jcondor98/avrtmon/resources/schematics/pcb-layout.jpg

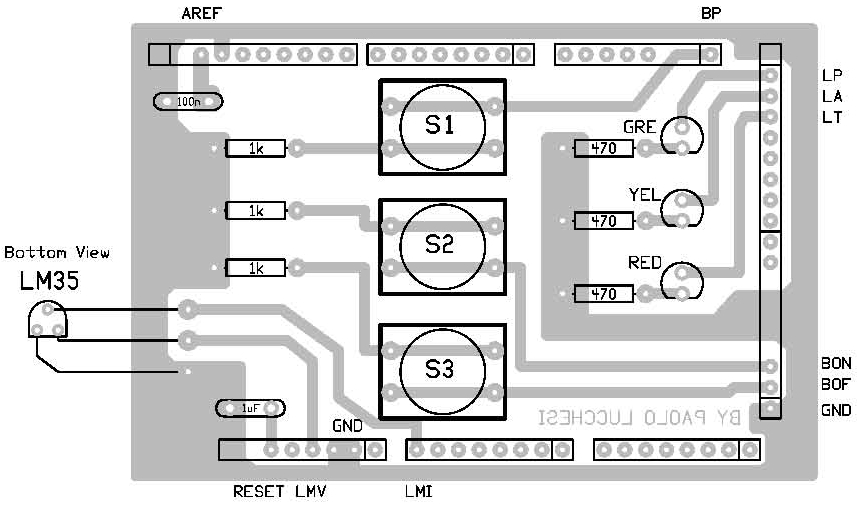
resources/schematics/pcb-layout.jpg
