jcondor98/avrtmon/resources/schematics/pcb-master.jpg

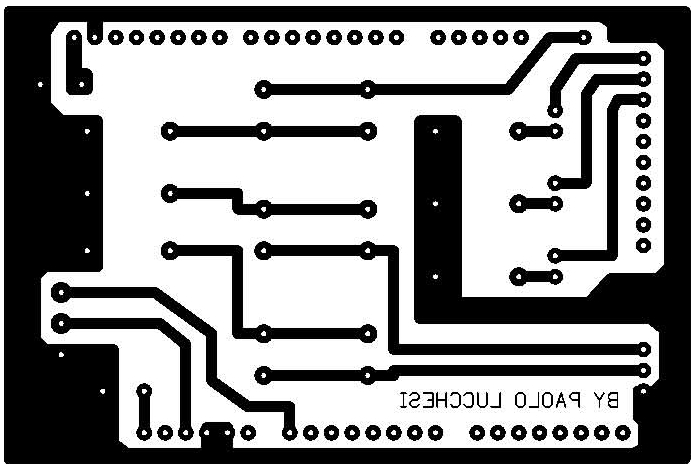
resources/schematics/pcb-master.jpg
