jcondor98/avrtmon/resources/schematics/schematics.jpg

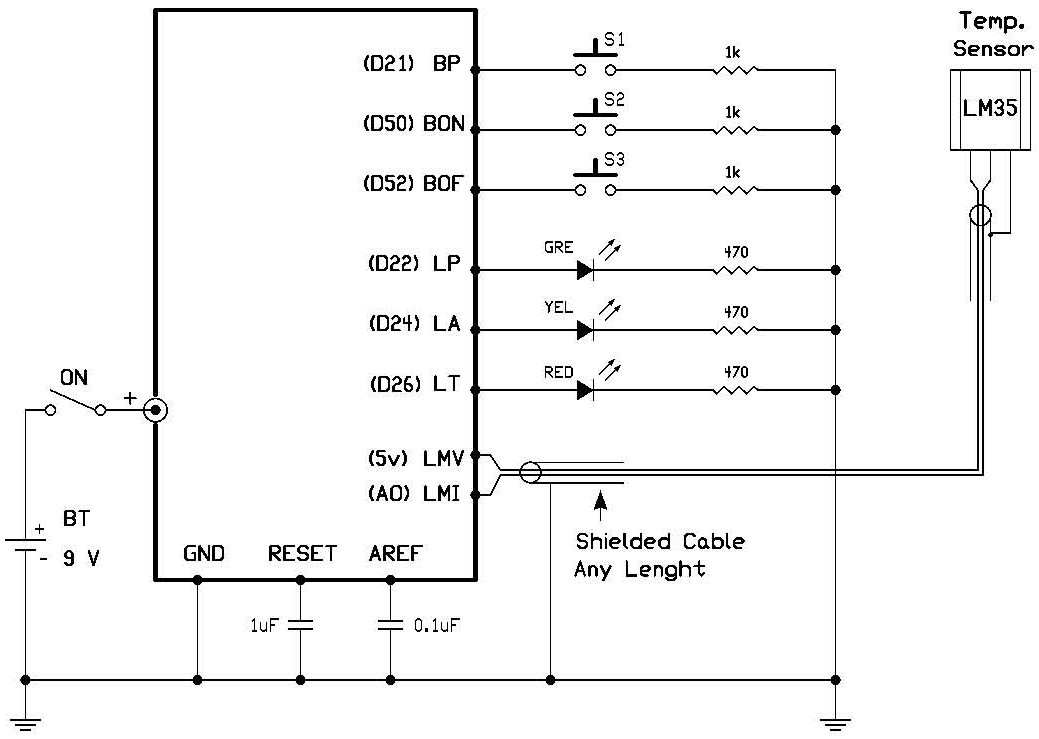
resources/schematics/schematics.jpg
