jcondor98/avrtmon/resources/config/test.csv

field1 | uint8_t | 1
field2 | uint16_t | 2
field3 | uint32_t | 3
