jcondor98/avrtmon/(list of files, drawings)

Other design files:
resources/schematics/pcb-layout.pcb
