jcondor98/avrtmon/sources/host/shell_commands.c

// AVR Temperature Monitor -- Paolo Lucchesi
// Program shell - Commands
#include <stdio.h>
#include <stdlib.h>
#include <stdint.h>
#include <string.h>
#include <assert.h>

#include "shell.h"
#include "list.h"
#include "serial.h"
#include "temperature.h"
#include "communication.h"
#include "debug.h"


// Declare a shell_storage_t variable casted from an opaque pointer
#define _storage_cast(st,opaque) shell_storage_t *st=(shell_storage_t*)(opaque)

// Handier function to send and receive packets
#define SERIAL_CTX (st->serial_ctx) // Must be the context in EVERY function below
#define psend(type,data,data_size)\
  communication_craft_and_send(SERIAL_CTX,type,data,data_size)
#define precv(p) communication_recv(SERIAL_CTX,p)
#define pcmd(cmd,arg,arg_size) communication_cmd(SERIAL_CTX,cmd,arg,arg_size)

// Type definition for the internal shell storage
typedef struct _shell_storage_s {
  serial_context_t *serial_ctx;
  list_t *dbs;
  unsigned db_incr_counter; // Incremental counter for DB IDs
} shell_storage_t;

// Wrapper to destroy DBs when destroying 'dbs'
static void _temperature_db_item_destroyer(void *db) {
  temperature_db_delete(db);
}


// Allocate and initialize a shell storage
// Returns an opaque pointer to the allocated storage, or NULL on failure
void *shell_storage_new(void) {
  shell_storage_t *st = malloc(sizeof(shell_storage_t));
  if (!st) return NULL;

  st->dbs = list_new();
  if (!st->dbs) {
    free(st);
    return NULL;
  }

  SERIAL_CTX = NULL;  // i.e. not connected
  st->db_incr_counter = 0;
  return (void*) st;
}

// Cleanup this shell environment (i.e. free memory, close descriptors...)
// Also frees the shell storage data structure itself
void shell_cleanup(shell_t *s) {
  if (!s) return;
  _storage_cast(st, s->storage);

  // Close the connection with the tmon, if any
  if (SERIAL_CTX && serial_close(SERIAL_CTX) != 0)
    err_log("Could not close the tmon file descriptor");

  // Free the storage
  list_delete(st->dbs, _temperature_db_item_destroyer);
  free(st);
}



// CMD: connect
// Usage: connect <device_path>
// Connect to an avrtmon, given its device file (usually under /dev)
// If it is already connected, reconnect
int connect(int argc, char *argv[], void *storage) {
  _storage_cast(st, storage);
  if (argc < 2) return 1;

  if (SERIAL_CTX)
    fputs("Open serial context found; reconnecting\n", stderr);
  else { // Open a descriptor for the tmon
    SERIAL_CTX = serial_open(argv[1]);
    sh_error_on(!SERIAL_CTX, 2, "Unable to connect to the tmon");
  }

  // Estabilish the connection
  sh_error_on(communication_connect(SERIAL_CTX) != 0, 3,
      "Could not send a handshake packet");

  return 0;
}


// CMD: disconnect
// Usage: disconnect
// Close an existing connection - Has no effect on the tmon
int disconnect(int argc, char *argv[], void *storage) {
  _storage_cast(st, storage);
  if (argc != 1) return 1;
  sh_error_on(!SERIAL_CTX, 2, "tmon is not connected");

  int ret = serial_close(SERIAL_CTX);
  SERIAL_CTX = NULL; // i.e. set to disconnected
  sh_error_on(ret != 0, 3, "Could not close the tmon file descriptor");

  return 0;
}


// CMD: download
// Usage: download
// Download all the temperatures from the tmon, creating a new database
// The communication happens as follows:
// 1] [HOST] <CMD> Request to download
// 2] [AVR]  If next (or first) DB is not empty:
//             <CTR> send DB info
// 3] [AVR]  While there are temperatures in the current DB:
//             <DAT> Send temperatures in data bursts (i.e. in bulk)
// 4] [AVR]  If there is another DB, goto [2]
// 5] [AVR]  <CTR> Piggyback CTR packet with no carried data means end of comm.
int download(int argc, char *argv[], void *storage) {
  _storage_cast(st, storage);
  if (argc > 1) return 1;
  sh_error_on(!SERIAL_CTX, 2, "tmon is not connected");

  // Store DBs in a list
  list_t *db_list = list_new();
  sh_error_on(!db_list, 2, "Could not create new linked list");

  // DB which is currently in reception, with variables to store metadata
  uint8_t db_id;
  uint16_t db_reg_resolution, db_reg_interval;
  temperature_id_t db_size;
  temperature_db_t *db_current = NULL;

  // Buffer and variables for received packets
  packet_t pack_rx[1];
  unsigned char type, data_size;


  // Send a download command to the tmon
  if (pcmd(CMD_TEMPERATURES_DOWNLOAD, NULL, 0) != 0) {
    list_delete(db_list, _temperature_db_item_destroyer);
    sh_error(3, "Could not send CMD packet");
  }

  // Main downloader loop
  while (1) {
    // Receive new packet
    if (precv(pack_rx) != 0) {
      err_log("Unable to receive packet");
      break;
    }
    type = packet_get_type(pack_rx);
    data_size = packet_data_size(pack_rx);

    // New database incoming
    if (type == PACKET_TYPE_CTR) {
      if (data_size == 0) { // No more data to receive
        if (list_size(db_list) == 0) // No temperatures were received
          list_delete(db_list, NULL);
        else {
          list_concat(st->dbs, db_list);
          st->db_incr_counter = db_id + 1; // i.e. += Last ID received
        }
        return 0;
      }

      else if (data_size == sizeof(temperature_db_info_t)) { // New DB incoming
        temperature_db_info_extract(pack_rx->data, &db_id, &db_size,
            &db_reg_resolution, &db_reg_interval);
        db_id += st->db_incr_counter;
        db_current = temperature_db_new(db_id, db_size,
            db_reg_resolution, db_reg_interval, NULL);
        assert(db_current);
        list_add(db_list, db_current);
      }

      else break; // Error: unexpected packet data size
    }

    // New temperatures incoming
    else if (type == PACKET_TYPE_DAT) {
      const char *err_msg = NULL;
      const unsigned burst = data_size / sizeof(temperature_t);
      float converted[burst];

      // Handle errors
      if (!db_current)
        err_msg = "NULL reference to current database";
      else if (db_current->size < db_current->used + burst)
        err_msg = "Too many temperatures received for this database";
      else if (burst == 0)
        err_msg = "Received DAT packet with no temperatures";
      if (err_msg) {
        err_log(err_msg);
        break;
      }

      // No errors occurred
      for (size_t i=0; i < burst; ++i)
        converted[i] = temperature_raw2float(((uint16_t*) pack_rx->data)[i]);
      temperature_register_bulk(db_current, burst, converted);
    }

    else break; // Error: unexpected packet type
  }


  // Error handler
  list_delete(db_list, _temperature_db_item_destroyer);
  sh_error(3, "Unexpected communication failure");
}


// CMD: tmon-reset
// Usage: tmon-reset
// Reset the internal temperatures DB of the tmon
int tmon_reset(int argc, char *argv[], void *storage) {
  _storage_cast(st, storage);
  if (argc != 1) return 1;

  sh_error_on(!SERIAL_CTX, 2, "tmon is not connected");
  sh_error_on(pcmd(CMD_TEMPERATURES_RESET, NULL, 0) != 0, 2,
      "Could not send CMD packet");

  return 0;
}


// CMD: tmon-config
// Usage: tmon-config list
//        tmon-config get <field>
//        tmon-config set <field> <value>
// Manipulate the tmon configuration
int tmon_config(int argc, char *argv[], void *storage) {
  _storage_cast(st, storage);
  if (argc < 2 || argc > 4) return 1;

  // List the configuration fields
  if (strcmp(argv[1], "list") == 0) {
    if (argc != 2) return 1;
    for (config_field_t f=0; f < CONFIG_FIELD_COUNT; ++f)
      puts(config_field_str(f));
    return 0;
  }

  // Get a config field
  else if (strcmp(argv[1], "get") == 0) {
    if (argc != 3) return 1;
    config_field_t f;

    sh_error_on(!SERIAL_CTX, 2, "tmon is not connected");
    sh_error_on(config_field_id(argv[2], &f) != 0, 2, "Invalid config field");

    // Send a CONFIG_GET_FIELD command to the tmon
    sh_error_on(pcmd(CMD_CONFIG_GET_FIELD, &f, sizeof(config_field_t)), 3,
        "Could not send CMD packet");

    // Retrieve the field from the tmon
    packet_t pack_rx[1];
    sh_error_on(precv(pack_rx), 3, "Could not receive config field value");

    unsigned char type = packet_get_type(pack_rx);
    sh_error_on(type == PACKET_TYPE_CTR, 3,
        "tmon did not recognize the choosen config fiels");
    sh_error_on(type != PACKET_TYPE_DAT, 3,
        "Unexpected response packet type");

    // Handle the received config field value
    // We assume that every config field is an integer
    void *field_val = (void*) pack_rx->data;
    size_t field_size = packet_data_size(pack_rx);
    switch (field_size) {
      case 1:
        printf("%s: %hhu\n", argv[2], *((uint8_t*) field_val));
        break;
      case 2:
        printf("%s: %hu\n", argv[2], *((uint16_t*) field_val));
        break;
      case 4:
        printf("%s: %u\n", argv[2], *((uint32_t*) field_val));
        break;
      default:
        printf("Error: size of config field (%zu) is not supported\n", field_size);
        return 2;
    }
  }

  // Set a config field
  // NOTE: We assume that, for simplicity, a config field can be an integer
  // (indeed, it is like that in this configuration). The code below shall be
  // changed on other requirements (e.g. fields that are floats or structs)
  else if (strcmp(argv[1], "set") == 0) {
    if (argc != 4) return 1;
    config_field_t f;

    sh_error_on(!SERIAL_CTX, 2, "tmon is not connected");
    sh_error_on(config_field_id(argv[2], &f) != 0, 2, "Invalid config field");

    // Parse the value for the configuration field
    int value = atoi(argv[3]);

    // Compose the config field setter
    unsigned f_size = config_get_size(f);
    char _f_setter[sizeof(config_setter_t) + f_size];  // Room for the setter
    config_setter_t *f_setter = (config_setter_t*) &_f_setter;

    // Assign ID and value to the setter
    f_setter->id = f;
    switch (f_size) {
      case 1:
        *((uint8_t*) f_setter->value) = (uint8_t) value;
        break;
      case 2:
        *((uint16_t*) f_setter->value) = (uint16_t) value;
        break;
      case 4:
        *((uint32_t*) f_setter->value) = (uint32_t) value;
        break;
      default:
        printf("Error: size of config field (%u) is not supported\n", f_size);
        return 2;
    }

    // Send the proper CMD packet
    sh_error_on(pcmd(CMD_CONFIG_SET_FIELD, f_setter, sizeof(_f_setter)), 2,
        "Could not send CMD packet");
  }

  else return 1;  // Unknown command, error
  return 0;
}


// CMD: tmon-start
// Usage: tmon-start
// Start registering temperatures
int tmon_start(int argc, char *argv[], void *storage) {
  _storage_cast(st, storage);
  if (argc != 1) return 1;
  sh_error_on(!SERIAL_CTX, 2, "tmon is not connected");
  sh_error_on(pcmd(CMD_START, NULL, 0) != 0, 3,
      "Could not send CMD packet");
  return 0;
}


// CMD: tmon-stop
// Usage: tmon-stop
// Stop registering temperatures
int tmon_stop(int argc, char *argv[], void *storage) {
  _storage_cast(st, storage);
  if (argc != 1) return 1;
  sh_error_on(!SERIAL_CTX, 2, "tmon is not connected");
  sh_error_on(pcmd(CMD_STOP, NULL, 0) != 0, 3,
      "Could not send CMD packet");
  return 0;
}



// CMD: tmon-set-resolution
// Usage: tmon-set-resolution <value>
// Set the timer resolution for the next DB until the tmon is reset
int tmon_set_resolution(int argc, char *argv[], void *storage) {
  _storage_cast(st, storage);
  if (argc != 2) return 1;
  sh_error_on(!SERIAL_CTX, 2, "tmon is not connected");

  uint16_t resolution = atoi(argv[1]);
  sh_error_on(resolution == 0, 2, "Invalid resolution");

  sh_error_on(pcmd(CMD_SET_RESOLUTION, &resolution, sizeof(uint16_t)) != 0, 3,
      "Could not send CMD packet");
  return 0;
}



// CMD: tmon-set-interval
// Usage: tmon-set-interval <value>
// Set the timer interval for the next DB until the tmon is reset
int tmon_set_interval(int argc, char *argv[], void *storage) {
  _storage_cast(st, storage);
  if (argc != 2) return 1;
  sh_error_on(!SERIAL_CTX, 2, "tmon is not connected");

  uint16_t interval = atoi(argv[1]);
  sh_error_on(interval == 0, 2, "Invalid interval");

  sh_error_on(pcmd(CMD_SET_INTERVAL, &interval, sizeof(uint16_t)) != 0, 3,
      "Could not send CMD packet");
  return 0;
}


// CMD: tmon-echo
// Usage: tmon-echo <arg> [arg2 arg3 ...]
// Send a string to the tmon, which should send it back
int tmon_echo(int argc, char *argv[], void *storage) {
  _storage_cast(st, storage);
  if (argc < 2) return 1;
  char str[PACKET_DATA_MAX_SIZE - 1];

  sh_error_on(!SERIAL_CTX, 2, "tmon is not connected");

  // Reassemble the separated argv[] token into one string
  size_t str_len = 0;
  for (int i=1; i < argc; ++i) {
    size_t tok_len = strlen(argv[i]);
    sh_error_on(
        (str_len ? str_len+1 : 0) + tok_len >= PACKET_DATA_MAX_SIZE - 2, 2,
        "Error: arguments must be at most %d characters long " "in total\n",
        PACKET_DATA_MAX_SIZE - 2);
    if (str_len) str[str_len++] = ' ';
    strcpy(str + str_len, argv[i]);
    str_len += tok_len;
  }
  str[str_len] = '\0';

  // Send the string to the tmon with a CMD_ECHO command
  sh_error_on(pcmd(CMD_ECHO, str, str_len + 1) != 0, 3,
      "Could not send the string to echo to the tmon");

  // Get the string back from the tmon
  packet_t pack_rx;
  sh_error_on(precv(&pack_rx), 3,
      "Could not receive the echo string back from the tmon");

  // Check the packet data size and prepare the received string to be printed
  const unsigned char pack_rx_size_expected = PACKET_HEADER_SIZE +
    str_len + sizeof(crc_t);
  const unsigned char pack_rx_size = packet_get_size(&pack_rx);
  sh_error_on(pack_rx_size != pack_rx_size_expected, 2,
      "Error: The received packet is %hhu bytes long, expected %hhu\n",
      pack_rx_size, pack_rx_size_expected);
  pack_rx.data[str_len] = '\0'; // Substitute first CRC byte with string terminator

  // Print the received string and return
  puts((char*) pack_rx.data);
  return 0;
}


// CMD: list
// Usage: list
// List the databases present in the storage
int list(int argc, char *argv[], void *storage) {
  _storage_cast(st, storage);
  if (argc > 1) return 1;

  printf("DBs present: %zu\n\n", list_size(st->dbs));

  // Print databases metadata
  list_iterator_t it = list_iterator_new(st->dbs);
  while (it) {
    temperature_db_t *db = list_iterator_getvalue(it);
    if (!db) fprintf(stderr, "Error: NULL reference to database\n");
    else {
      printf("Database ID: %u\n", db->id);
      if (db->desc) printf("%s\n", db->desc);
      printf("Number of temperatures: %u\n\n", db->size);
    }
    it = list_iterator_next(it);
  }

  return 0;
}


// CMD: export
// Usage: export <db_id> <output_filepath>
// Export a database (as text, newline-separated float temperatures)
// TODO: Make this reentrant/thread-safe (static variable emulates a closure)
static unsigned _db_id_to_find;
static int _db_has_id(void *_db) {
  temperature_db_t *db = _db;
  return (db && db->id == _db_id_to_find);
}

int export(int argc, char *argv[], void *storage) {
  _storage_cast(st, storage);
  if (argc != 3) return 1;

  _db_id_to_find = atoi(argv[1]);
  temperature_db_t *db = list_find(st->dbs, _db_has_id);

  sh_error_on(!db, 2, "Error: could not fetch database");
  sh_error_on(temperature_db_export(db, argv[2]) != 0, 3,
      "Error while exporting database of ID %u", _db_id_to_find);

  return 0;
}



// Set of all the shell commands
static shell_command_t _shell_commands[] = {
  (shell_command_t) { // CMD: connect
    .name = "connect",
    .help = "Usage: connect <device_path>\n"
      "Connect to an avrtmon, given its device file (usually under /dev)",
    .exec = connect
  },

  (shell_command_t) { // CMD: disconnect
    .name = "disconnect",
    .help = "Usage: disconnect\n"
      "Close an existing connection - Has no effect on the tmon",
    .exec = disconnect
  },

  (shell_command_t) { // CMD: download
    .name = "download",
    .help = "Usage: download\n"
      "Download all the temperatures from the tmon. creating a new database",
    .exec = download
  },

  (shell_command_t) { // CMD: tmon-reset
    .name = "tmon-reset",
    .help = "Usage: tmon-reset\n"
      "Reset the internal temperatures DB of the tmon",
    .exec = tmon_reset
  },

  (shell_command_t) { // CMD: tmon-config
    .name = "tmon-config",
    .help = "Usage: tmon-config list\n"
            "       tmon-config get <field>\n"
            "       tmon-config set <field> <value>\n"
            "Manipulate the tmon configuration",
    .exec = tmon_config
  },

  (shell_command_t) { // CMD: tmon-start
    .name = "tmon-start",
    .help = "Usage: tmon-start\n"
      "Start registering temperatures",
    .exec = tmon_start
  },

  (shell_command_t) { // CMD: tmon-stop
    .name = "tmon-stop",
    .help = "Usage: tmon-stop\n"
      "Stop registering temperatures",
    .exec = tmon_stop
  },

  (shell_command_t) { // CMD: tmon-set-resolution
    .name = "tmon-set-resolution",
    .help = "Usage: tmon-set-resolution <value>\n"
      "Set the timer resolution for the next DB until the tmon is reset",
    .exec = tmon_set_resolution
  },

  (shell_command_t) {
    .name = "tmon-set-interval", // CMD: tmon-set-interval
    .help = "Usage: tmon-set-interval <value>\n"
      "Set the timer interval for the next DB until the tmon is reset",
    .exec = tmon_set_interval
  },

  (shell_command_t) { // CMD: tmon-echo
    .name = "tmon-echo",
    .help = "Usage: tmon-echo <arg> [arg2 arg3 ...]\n"
            "Send a string to the tmon, which should send it back",
    .exec = tmon_echo
  },

  (shell_command_t) { // CMD: list
    .name = "list",
    .help = "Usage: list\n"
      "List the databases present in the storage",
    .exec = list
  },

  (shell_command_t) { // CMD: export
    .name = "export",
    .help = "Usage: export <db_id> <output_filepath>\n"
      "Export a database (as text, newline-separated float temperatures)",
    .exec = export
  }
};

// This is the exposed shell commands set
shell_command_t *shell_commands = _shell_commands;
size_t shell_commands_count = sizeof(_shell_commands) / sizeof(shell_command_t);
