jcondor98/avrtmon/(commit log)

2019-08-06 Added complete CRC implementation
    Also, I have started to program the entire packet-switched communication
    layer
2019-08-07 Refactoring and fixed CRC calc in packet_craft
    [packet.c]
2019-08-07 Fixed packet integrity checks and overall refactor
    [packet.c]
2019-08-11 Rewrote serial interface from scratch
    The serial API was redesigned from scratch to be independent on the
    packet interface
    [serial.c]
2019-08-12 Finished draft implementation of serial interface
    Still many many things to fix
    [serial.c]
2019-08-17 Finished serial interface
    The serial interface is now working fine.
    The only known issue (which is a well-known one for serial
    implementations made with interrupts on AVR boards) is that if you send
    too many bytes in one stroke, you will loose some of them.
    After some empiric tests, the baud rate was changed from 19200 to 57600.
    At 19200, a maximum of 29 bytes can be sent without losses. At 57600,
    you can send up to 40 bytes (which is beyond the new designed size for a
    packet) maintaining losses infeasible, but you can also go further than
    that.
    [serial.c]
2019-08-20 Implemented LM35 sensor interface (with ADC)
2019-08-20 Finished LM35 sensor interface (with tests)
2019-08-22 Implemented temperature database (with tests)
    Wrote a complete implementation of the temperature database. Also, a
    handy, abstract header has been written to handle the EEPROM as a
    generic NVM.
    To test the temperature DB properly, a mock NVM implementation has been
    realized.
2019-08-25 Overall refactor of the entire codebase
    The entire GNU Make framework was redesigned to handle both host-side
    and avr-side compilation and to place object files in a dedicated
    directory, based on the target architecture in use.
    A common test framework for host-side testing was added, and every test
    was modified to use it.
    Minor bugfixes and refactor operations were performed for project source
    files
    [lmsensor.c, packet.c, serial.c, temperature.c]
2019-09-09 Finished parameterized AVR config implementation
    Source and header templates have been written for AVR-side
    configuration, as well as an utility to generate usable source and head
    files given a CSV configuration which specify every field, with its type
    and default value.
    The mock NVM implementation for testing have been modified; the changes
    made were not avoidable, as the way of using the NVM in the project has
    changed. Rafactoring and modification of the temperature db module is
    urgent.
    [default.csv, dumb.csv, test.csv]
2019-09-09 Fixed temperature db module to work with NVM
    The temperature db now support the new (and better) approach to the NVM
    use, but there is a problem on how to keep track of the configuration
    size in the computation of the db capacity. Likely, a new module which
    takes care of initializing the entire NVM image is required.
    [temperature.c]
2019-09-27 Ended overall (and big) refactor
    Now, the mock NVM implementation seems to work without any issue.
    The tests for the config and temperature modules have been rewritten.
    Also, minor bugs were fixed.
    [nvm.c, temperature.c]
2019-10-29 Added temperature timer and handler
2019-10-29 Added buttons handler and improved tests
    A button handler (to be tested) now allows to start and stop the tmon
    via hardware buttons.
    Minor fixes and improvements were performed on tests and Makefile.
    Now all the tests can be performed with 'make test'
    [config.c, main.c, nvm.c, temperature.c]
2019-11-04 Host modules written and repo structure changed
    A bunch of modules have been written for the host side:
    * shell - A flexible command line utility [TESTED]
    * list - A simply linked list [TESTED]
    * temperature_db
    The repo structure was slightly modified (for AVR)
2019-11-21 Fixed minor issues with unit tests
    [nvm.c, packet.c]
2019-11-30 Debug layer for host side and various fixes
    [command.c, communication.c, main.c, packet.c]
2019-12-12 Fixed serial communication for both sides
    AVR-side serial layer was bugged as hell (didn't figure out so far), and
    some things at host-side (e.g. read timeouts) were... Well, ambiguous.
    Now everything works decently.
    [communication.c, main.c, packet.c, serial.c, shell_commands.c]
2020-03-22 Restore repo to consistent state after huge mess
    The inability to realize a perfectly working serial host module caused a
    huge mess, as careless code modifies were made all the time. The
    codebase has been restored to a consistent state, and many modules were
    improved.
    The serial module works decently in completely raw mode (non canonical);
    the read (RX) function is delegated to a separated thread, with the aid
    of a multi-threaded ringbuffer data structure. Serial tests were
    rewritten.
    Some debug modules were added, and for host-side a unified debug
    facility had been developed.
2020-03-24 Fixed NVM and improved temperature data struct
    The NVM interface had been fixed to work transparently for avr-side and
    for testing (in "mock modality"). The temperature data structure had
    been rewritten to handle multiple databases inside the NVM.
    Moreover, the test suite is fully working and no tests fail.
    [config.c, nvm.c, temperature.c]
2020-03-24 Written complete button interface
2020-03-26 Temperature daemon module
    The 'lmsensor_timer' and 'temperature_handler' modules have been merged
    in a new module named 'temperature_daemon', which takes care of
    periodical temperature registrations.
    The main routine have been modified and now is almost complete.
    Configuration field concerning temperature registering timing and
    buttons have been added.
    [default.csv]
2020-03-27 Added temperature timer info in temperature DBs
2020-03-28 Various fixes and improvements to host-side
    - Improved linked list module
    - Corrected many bad memory leaks (I was aware of those since a long time)
    - Corrected temperature module
    - Bulk temperature get() and register() for temperature DB
    - Fixed communication commands
    [config.c, list.c, main.c]
2020-03-29 Various bugfixes and improvements
    - Fixed bug which denied communication reset
    - AVR communication command notification system for delivered packets
    - Fixed bug in `tmon-config get` host command
    - Modified default configuration
    [default.csv]
2020-03-31 Debug session
    - Fixed button handler bug which was inverting button pressing state (PINB bits are set if buttons are not pressed)
    - Host-side `list` command segmentation fault
    - Reviewed host-side communication layer source code
    - Written buttons module test
    - Fixed various bugs
    [default.csv]
2020-04-01 Reviewed serial host module
    The serial host module had been completely reviewed and I hope it won't
    need to be modified in the near future. In particular, the following
    changes had been committed:
    - Fixed stuck RX thread 'read()' call on host shell exit
    - Implemented correct and exhaustive error handling
    - Eliminated the now unneeded RX mutex for the 'ongoing' variable
    [serial.c]
2020-04-01 Partial codebase review and configurable LM pin
    - Reviewed lmsensor, buttons AVR-side modules
    - Reviewed host-side modules: list
    - Added configurable LM35 ADC pin
    [default.csv]
2020-04-03 Power saving and performance optimization
    Lots of power management had been performed, in particular:
    - The tmon sleeps the 99.9 percent of the time and wakes up on
    interrupts
    - Lots of unneeded modules are disabled
    - The tmon enters in ADC Noise Reduction sleep mode when getting a
    temperature from the LM sensor
    Also, by eliminating the active, busy-waiting delay in the main module,
    communication is faster by a magnitude.
    [buttons.c, communication.c, lmsensor.c, main.c, temperature_daemon.c]
2020-04-05 Complete, interrupt-based buttons debouncing
    Also added INT0 (i.e. pin D21) in the buttons module
    [default.csv]
2020-04-09 Global codebase review
    Lots of minor, mostly elegance fixes
    [default.csv, dumb.csv]
2020-04-11 Improved host communication module and commands
    - Packet send/recv failure now resets packet global ID
    - Implemented (simple polling) host-side communication passive wait
    - Data discarding on communication error
    - Fixed `tmon-config set` command
    - Improved host-side temperature download routine
    [communication.c, lmsensor.c, main.c, shell.c]
2020-04-13 Final pre-release code review
    The entire codebase has been reviewes, and things like a specification
    sheet and schematics have been added. Also, some AVR commands were added.
    [PCB.pcb, Schema.sch]
2020-04-13 Modified default config for PCB compatibility
    [default.csv]
2020-04-14 Revised documentation
    [pcb-layout.pcb, schematics.sch]
2020-04-15 Fixed serial minor bug and revised documentation
    [buttons.c, nvm.c, serial.c, temperature_daemon.c]
2020-04-18 Minor fixes
    -s option now works for host application.
    Removed printf() call used for debug purposes in 'export' host command
    [main.c, shell.c, temperature_specific.c]
2020-05-07 Corrected minor bug in packet interface
    packet_check_header() now asserts also on upper size packet limit
    [packet.c]
